razeb1t/Supermini-Reader/README.md

# 📟 Supermini-Reader

<p align="center">
  
  
  
  
  
  
</p>

**Карманная цифровая шпаргалка** на базе микроконтроллера ESP32-S3 SuperMini. С помощью этого устройства вы можете читать текст, загруженный через веб страницу 
### Загрузка в один клик через ДЛЯ РАЗНЫХ МК ---> [Веб загрузчик](https://razeb1t.github.io/Supermini-Reader-Web-loader.io/)

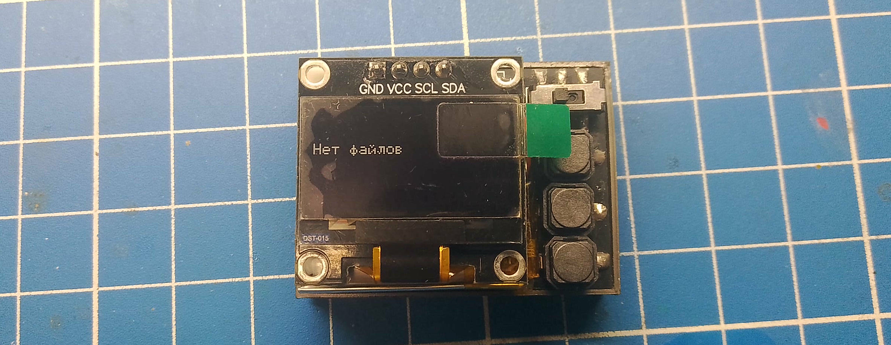
[picture p1: photo/photo2.jpg]
образец


---

### ⚠️ Дисклеймер
Создатель прошивки не несет ответственность за ваши действия. Если вас спалили я не виновен

*Использование прошивки означает ваше полное согласие с этими условиями*  

---
## Инструкция
**Кнопка вверх и вниз** - позволяют выбирать файл, листать страницы и регулировать яркостью (в Wifi режиме), зажать вверх и вниз одновременно -> калькулятор 

__Кнопка ОК__ - позволяет открывать/закрывать файлы, если зажать можно включить Wifi режим, если зажать в калькуляторе то будет выход

### Как подключать ИИ?
- Заходите на сайт https://proxyapi.ru/ , и входите в свой аккаунт
- Затем создаете свой API ключ
- Кидаете на счёт своего аккаунта минимум 200 руб. (не беспокойтесь, если выберете недорогой ИИ вывод +-150 руб на 1млн токенов то простенький промт будет стоит от 2 до 5 копеек)
- Выбираете модель ИИ на сайте https://proxyapi.ru/models/browse (рекомндую deepseek/deepseek-v4.1-flash-1017)
- После всего вставляете API ключ в настройках устройства, модель ИИ (рекомндую deepseek/deepseek-v4.1-flash-1017), а затем пишите имя и пароль от WiFi чтобы к нему подключилось устройство
---

## Обновление 1.6v
- Чат с ИИ (через ProxyAPI, в настройках через веб интерфейс вставляете API, пароль и имя Wi-Fi к которому надо подключиться и имя модели ИИ (каталог моделей https://proxyapi.ru/models/browse))
- Единое меню для функций, игр и для вызова чата с ИИ; команда 0000 в калькуляторе
- Добавление бокового бегунка в файлы

## Обновление 1.4v
- Изменён внешний интерфейс калькулятора
- Добавлена еще одна игра - тетрис, код в калькуляторе для активации: 0001

---
### Как загрузить пошагово
1) Зажимаем кнопку ОК (ждем включение Wifi режима)
2) Открываем на телефоне, ПК Wifi сети и ищем точку доступа которая написана на экране
3) Кликаем и вводим пароль (тоже написано на экране)
4) На телефоне автомотически перекидывает на нужную веб страницу, на ПК открываем браузер и вводим IP (тоже написано на экране)
5) Вводим любой заголовок и текст (на русском или английском языке)
6) После загрузки зажимаем ОК на устройстве и нас перекидывает на главное меню, и там нас ждет загруженный файл

По умолчанию стоит такое имя сети и пароль (по желанию можно изменить, если пароль пустой то сеть будет открытой, хотя поменять можно через веб): 
``` cpp
String AP_SSID = "Esp hpora";
String AP_PASS = "12345678";
```
> [!WARNING]
> На IOS нельзя удалять файлы, только изменять содержимое файлов и загружать новые (если вы зашли на страницу через "Регистрация в сети"), это легко исправить - вбиваете через браузер айпи который отображается на экране устройства  

---

| Компонент | Ссылка |
|---|---|
| ESP32-S3 supermini | [AliExpress](https://ali.click/authk16) |
| OLED 0.96 | [AliExpress](https://ali.click/0sthk16) |
| Кнопки | [AliExpress](https://ali.click/zmthk1m) |
| Переключатель | [AliExpress](https://ali.click/nm4xl1j) |
| Текстолит (двухсторонний) | [OZON](https://ozon.ru/t/EIpMMhm) |
| Преобразователь 5v,8v,9v,12v |[AliExpress](https://ali.click/431kk1u)|
| TP4056 |[AliExpress](https://ali.click/2v3xl17)|
| Аккумулятор (любой, рекомендуется 402025) |[Ozon](https://ozon.ru/t/sXkcoqy)|

 ---

#### Схема подключения -> [Веб загрузчик](https://razeb1t.github.io/Supermini-Reader-Web-loader.io/)
#### ESP32-S3 supermini (стандарт)

|Module|Pin 1|Pin 2|Pin 3|Pin 4|
|---|---|---|---|---|
|**📺 Display**|VCC→3V3|GND→GND|SCL→G13|SDA→G11|
|**🔘 Buttons**|UP→G5|DOWN→G7|OK→G6|-|

#### ESP32 C3 Supermini

|Module|Pin 1|Pin 2|Pin 3|Pin 4|
|---|---|---|---|---|
|**📺 Display**|VCC→3V3|GND→GND|SCL→G4|SDA→G2|
|**🔘 Buttons**|UP→G20|DOWN→G10|OK→G21|-|

#### ESP32

|Module|Pin 1|Pin 2|Pin 3|Pin 4|
|---|---|---|---|---|
|**📺 Display**|VCC→3V3|GND→GND|SCL→G23|SDA→G22|
|**🔘 Buttons**|UP→G17|DOWN→G4|OK→G16|-|

(ниже для ESP32-S3 Supermini)

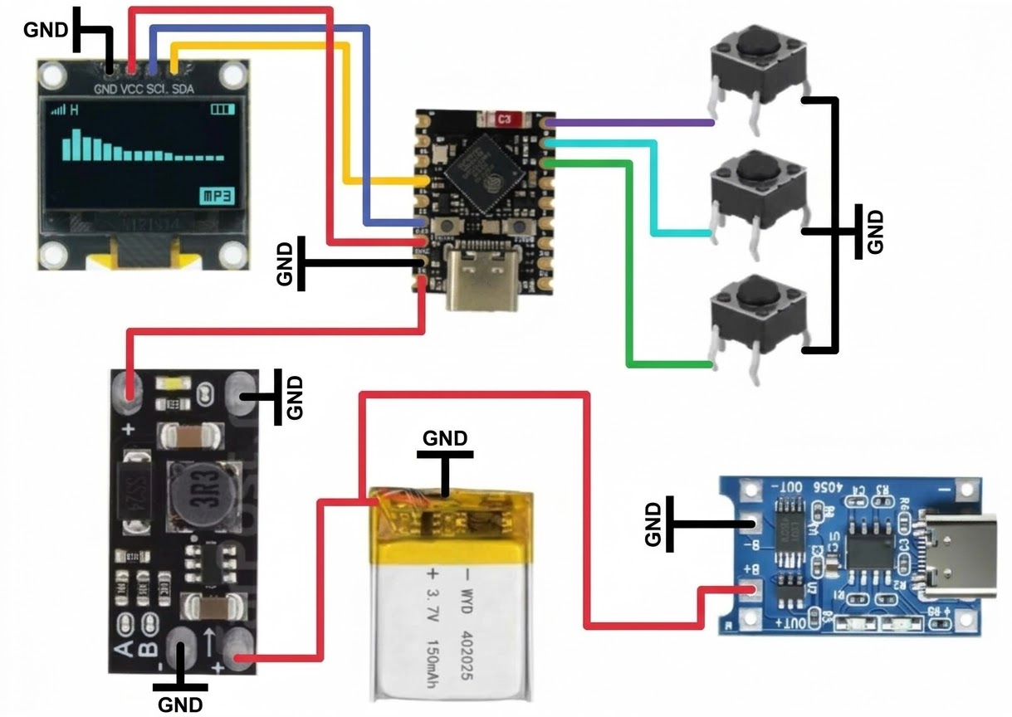
[picture p2: photo/photo4.jpg]


---

### ❓ Как прошить ❓

Переходим в мой веб загрузчик -> https://razeb1t.github.io/Supermini-Reader-Web-loader.io/
Выбираем МК, нужную версию, на устройстве (если Esp32 s3/c3 supermini) зажимаем BOOT, не отпуская BOOT нажимаем RESET, отпускаем BOOT - так устройство переводится в сосотояние прошивки

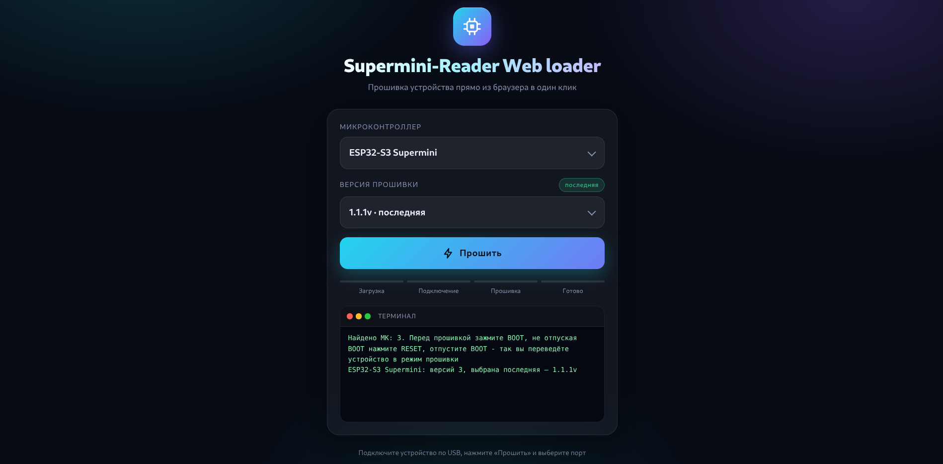
[picture p3: photo/photo5.png]


После прошивки обесточьте устройство и затем включите

Или (более муторный вариант) __ДЛЯ ESP32-S3 Supermini__ скачиваете 3 bin файла - botloader, partitions и firmware, переходите в веб загрузчик https://esptool.spacehuhn.com/, загружаете эти файлы и выставляете адреса:
botloader: 0
partitions: 8000
firmware: 10000
(без "0x" впереди)

---
## Изготовление

> [!NOTE]
> **ГАЙД УЖЕ НА [YOU TUBE!!!](https://youtu.be/IHZwgPZnhfI?si=5LoymI1fk4fz2pAS)**

Печатаем на глянцевой бумаге схему (в файле ЛУТ) **ВАЖНО РАЗМЕР 1 к 1** 

Более подробный и простой гайд от **AlexGyver про ЛУТ** 
[**You Tube**](https://youtu.be/NJTeIALlztI)

После успешного изготовление платы **ПРИМЕЧАНИЕ**, нужно отпаять 2 резистора на преобразователе а именно A и B

### Или вы можете заказать у какого-нибудь производителя платы PCB 
(GREBER прикреплен)

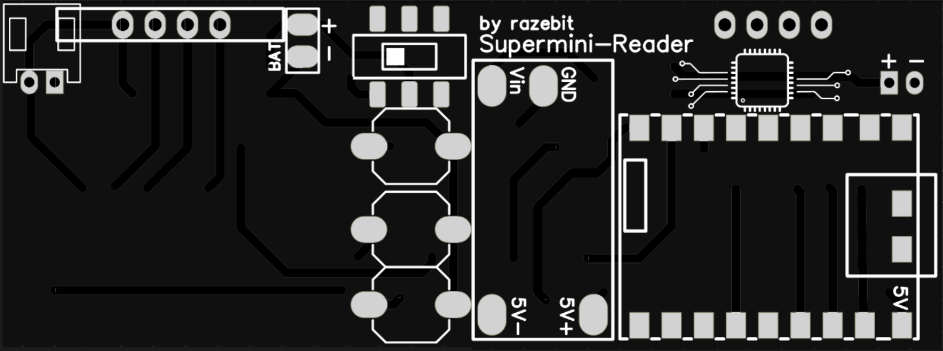
[picture p4: PCB/plata.png]


### Структура репозитория:
```text
Supermini-Reader/
├── 3D models/
|   ├── box for Supermini-Reader.stl
|   └── case for Supermini-Reader.stl
├── Code/
│   ├── scr/
|   |    └── main.cpp   <- исходный код 
│   ├── no_ota.cs
│   └── platform.ini
|
├── PCB/
|   ├── Supermini-Reader-v1.zip
|   └── plata.png
|
├── bin/
|   ├── bootloader.bin
|   ├── firmware.bin
|   └── partitions.bin
|
├── photo/
|   ├── photo2.png
|   ├── photo3.png
|   ├── photo4.png
|   └── photo5.png
|
├── ЛУТ/PDF/
|   ├── plata-niz.pdf
|   └── plata-verx.pdf
|
├── LICENSE
└── README.md
```
