razeb1t/Supermini-Reader/PCB/p.png

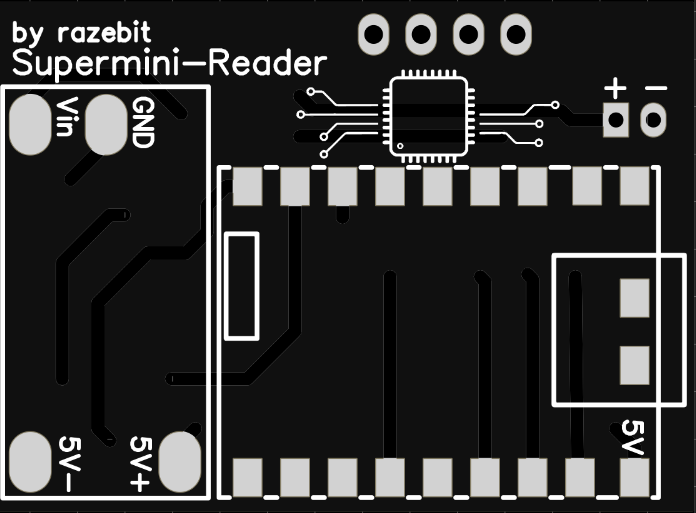
PCB/p.png
