razeb1t/Supermini-Reader/PCB/pered.png

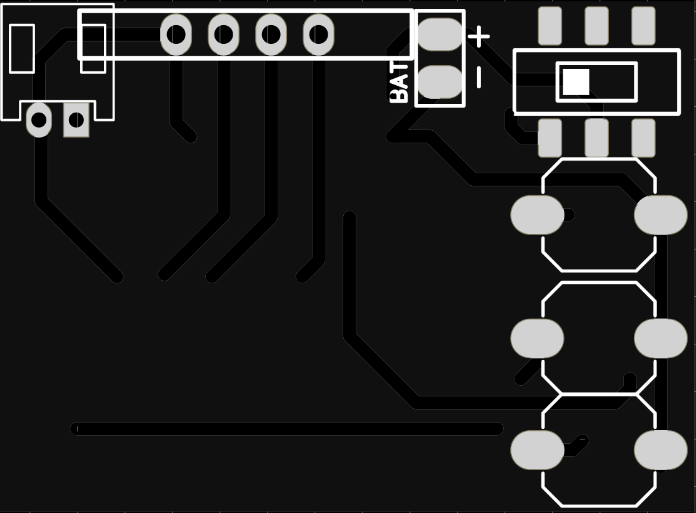
PCB/pered.png
