razeb1t/Supermini-Reader/photo/photo3.png

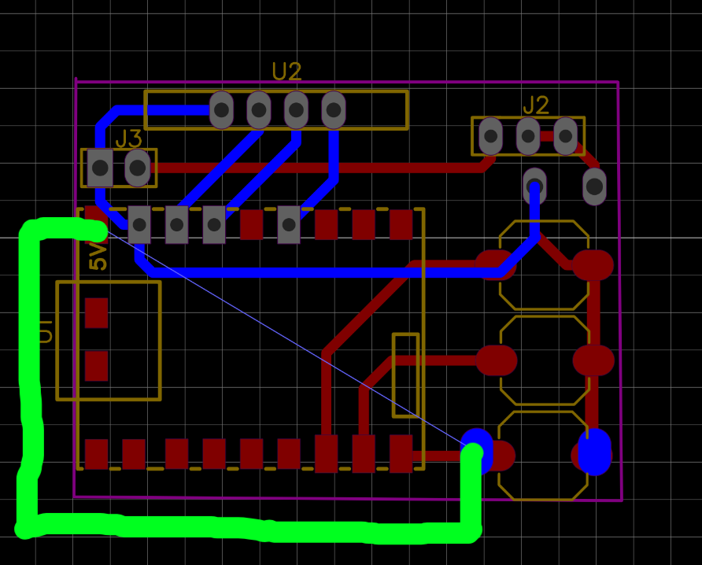
photo/photo3.png
