razeb1t/Supermini-Reader/photo/photo4.png

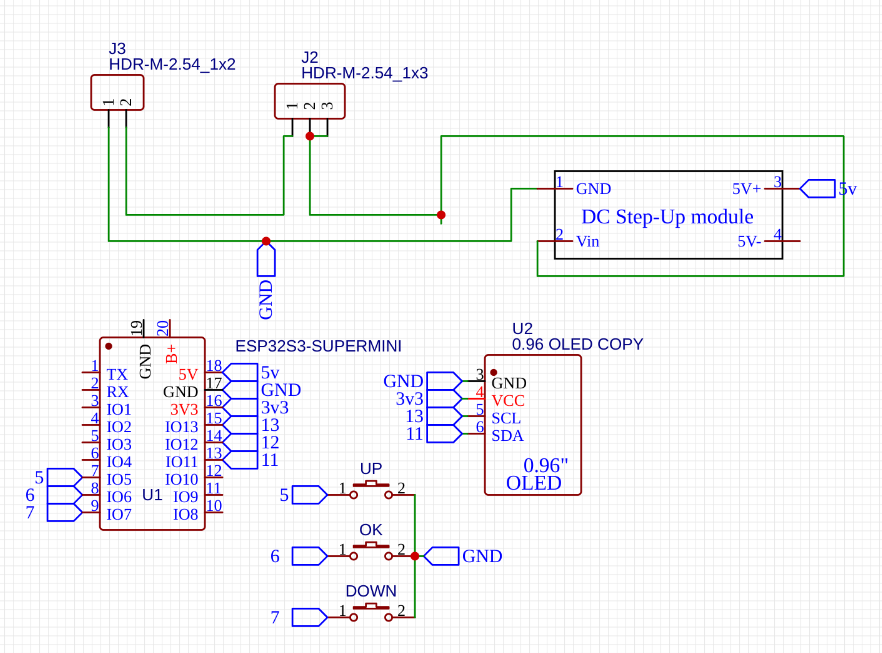
photo/photo4.png
