razeb1t/Supermini-Reader/photo/photo.png

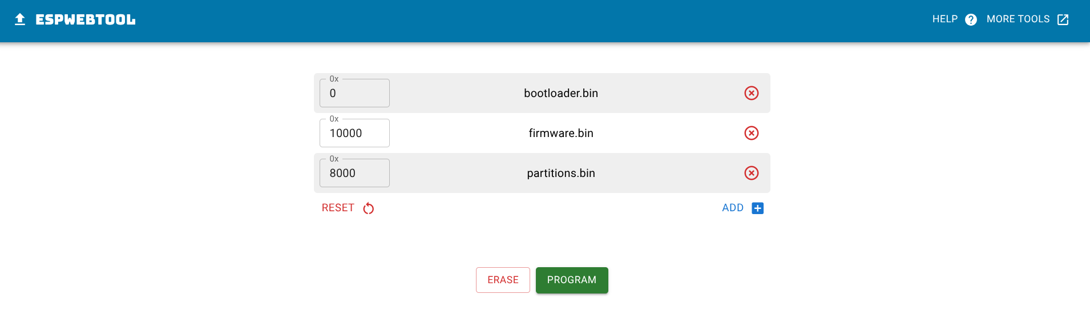
photo/photo.png
