razeb1t/Supermini-Reader/3D models/case for Supermini-Reader.stl

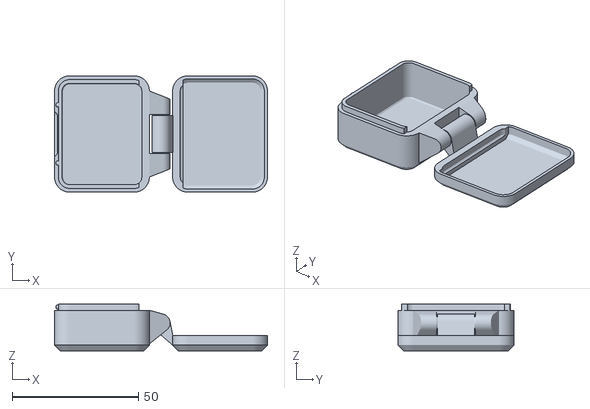
[picture p10: CAD file, 2026-11-04]
3D models/case for Supermini-Reader.stl
84.2 x 46.0 x 18.4
