razeb1t/Supermini-Reader/3D models/box for Supermini-Reader.stl

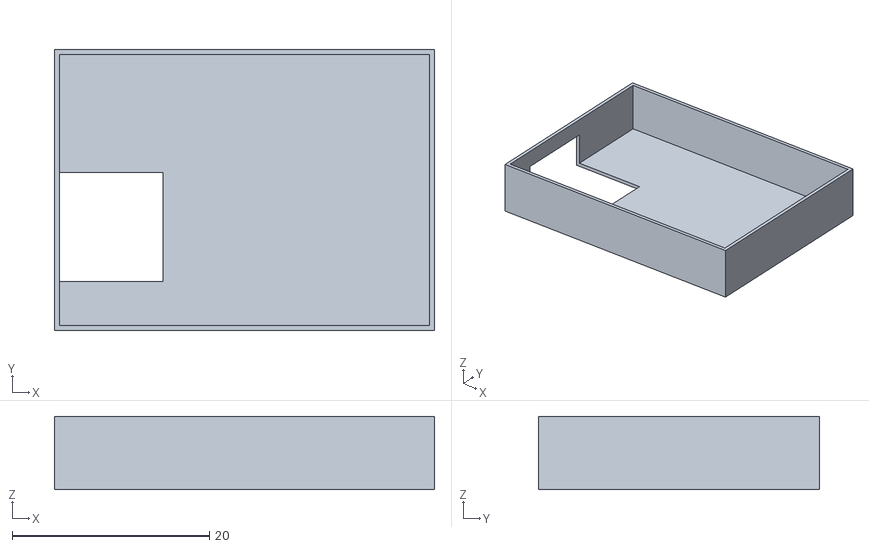
[picture p11: CAD file, 2026-11-04]
3D models/box for Supermini-Reader.stl
38.5 x 28.5 x 7.40
